0xfrq/studysphere/desktop/screenshots/1-tersembunyi.png

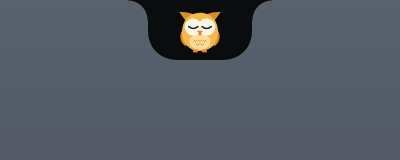
desktop/screenshots/1-tersembunyi.png
