0xfrq/studysphere/desktop/screenshots/3-terbuka.png

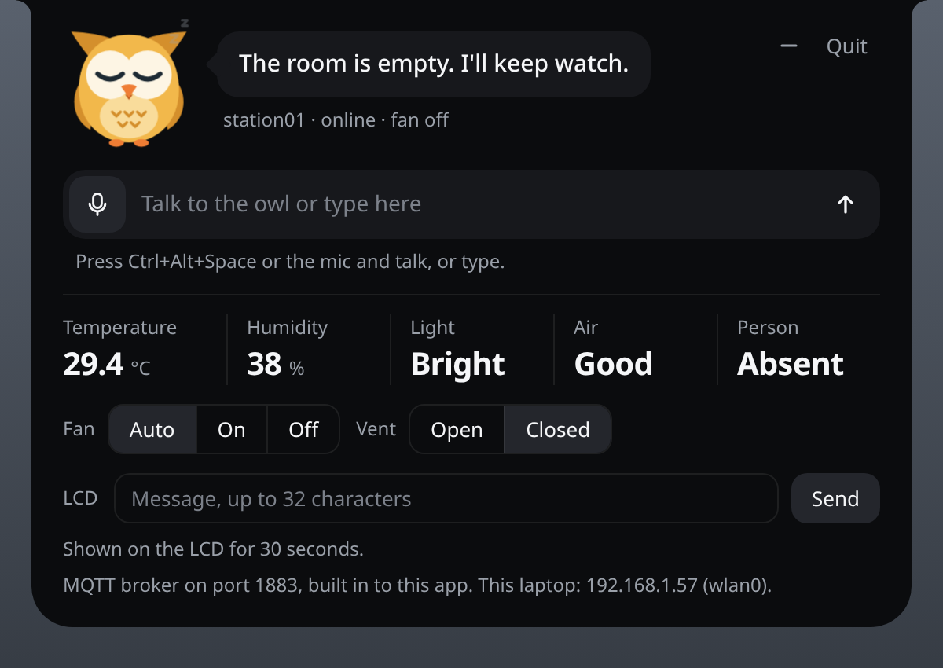
desktop/screenshots/3-terbuka.png
