0xfrq/studysphere/hardware/fab/render-bottom.png

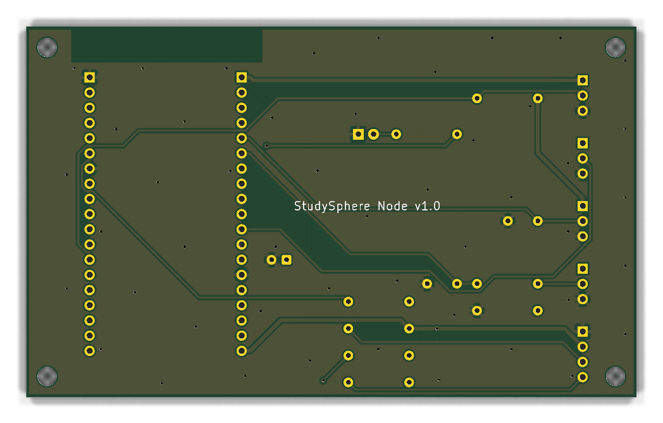
hardware/fab/render-bottom.png
