0xfrq/studysphere/hardware/fab/render-top.png

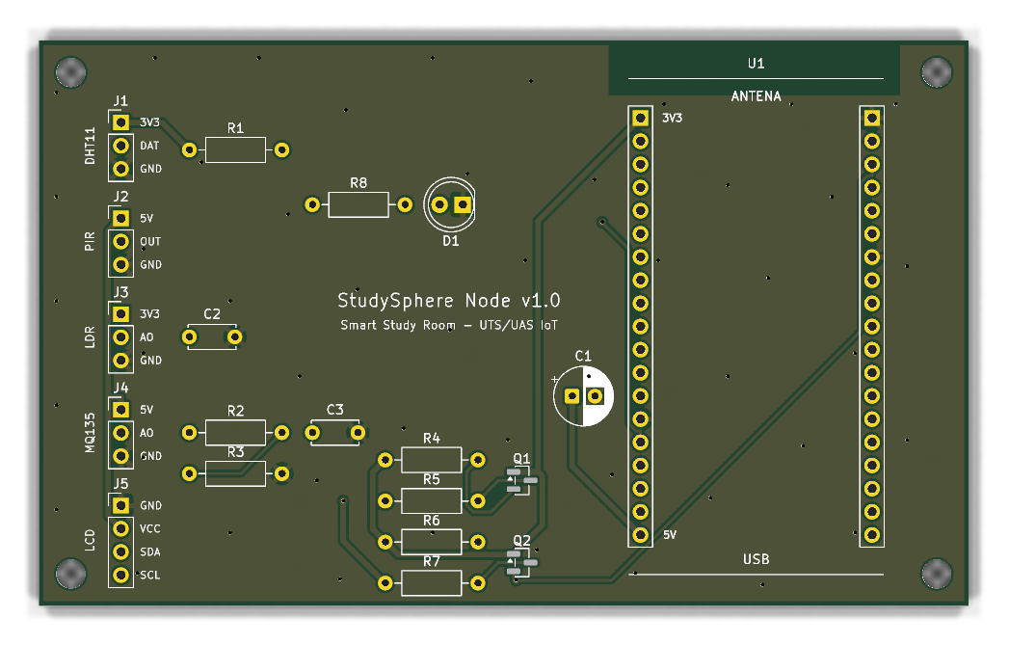
hardware/fab/render-top.png
