0xfrq/studysphere/hardware/fab/bom.csv

Ref | Value | Footprint | Qty
C1 | 100u 16V | Capacitor_THT:CP_Radial_D6.3mm_P2.50mm | 1
C2,C3 | 100n | Capacitor_THT:C_Disc_D5.0mm_W2.5mm_P5.00mm | 2
D1 | LED kuning | LED_THT:LED_D5.0mm | 1
J1 | DHT11 | Connector_PinHeader_2.54mm:PinHeader_1x03_P2.54mm_Vertical | 1
J2 | HC-SR501 | Connector_PinHeader_2.54mm:PinHeader_1x03_P2.54mm_Vertical | 1
J3 | Modul LDR | Connector_PinHeader_2.54mm:PinHeader_1x03_P2.54mm_Vertical | 1
J4 | MQ-135 | Connector_PinHeader_2.54mm:PinHeader_1x03_P2.54mm_Vertical | 1
J5 | LCD 16x2 I2C | Connector_PinHeader_2.54mm:PinHeader_1x04_P2.54mm_Vertical | 1
Q1,Q2 | BSS138 | Package_TO_SOT_SMD:SOT-23 | 2
R1,R2,R4,R5,R6,R7 | 10k | Resistor_THT:R_Axial_DIN0207_L6.3mm_D2.5mm_P10.16mm_Horizontal | 6
R3 | 15k | Resistor_THT:R_Axial_DIN0207_L6.3mm_D2.5mm_P10.16mm_Horizontal | 1
R8 | 220 | Resistor_THT:R_Axial_DIN0207_L6.3mm_D2.5mm_P10.16mm_Horizontal | 1
U1 | ESP32-DevKitC-V4 | studysphere:ESP32-DevKitC-V4_Socket | 1
