0xfrq/studysphere/hardware/fab/skematik.pdf

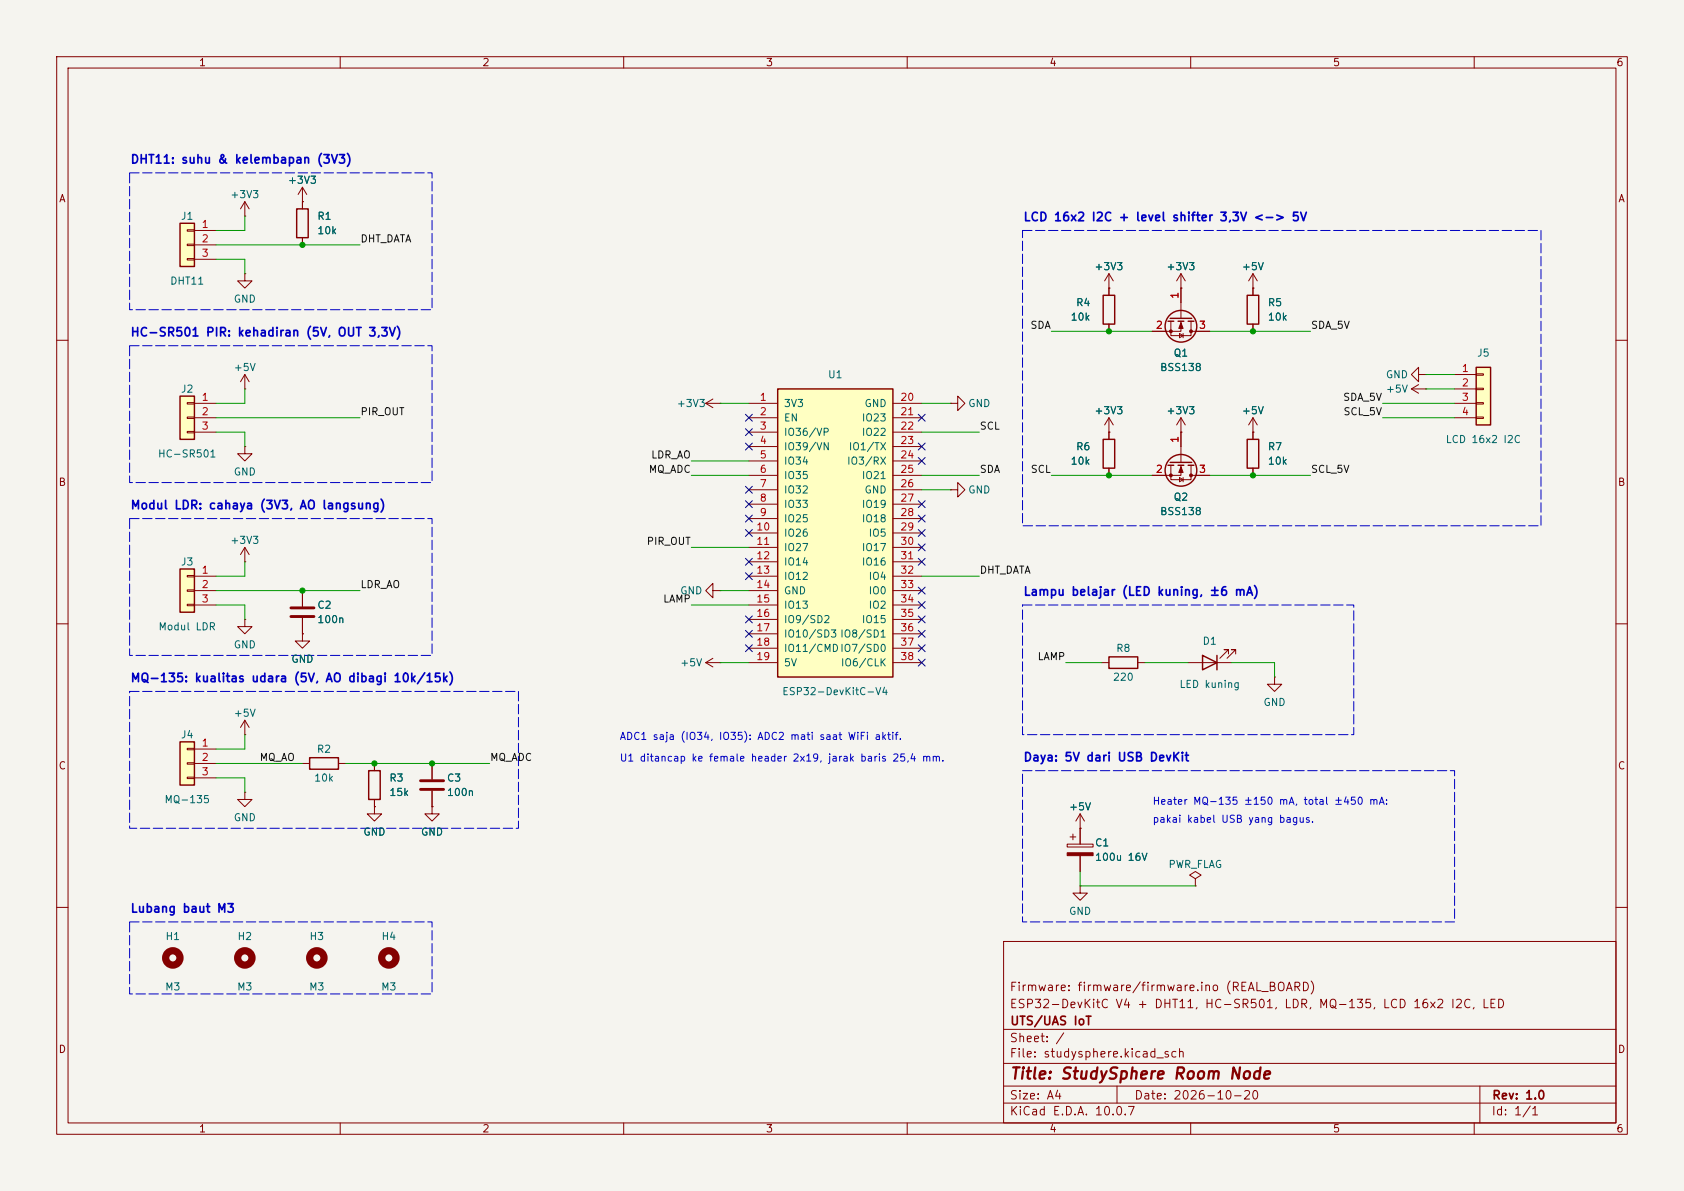
[picture p9: page 1]

SCL DHT_DATA PIR_OUT HC-SR501 PIR: kehadiran (5V, OUT 3,3V)

Modul LDR: cahaya (3V3, AO langsung)

Lampu belajar (LED kuning, ±6 mA)

MQ-135: kualitas udara (5V, AO dibagi 10k/15k)C3

pakai kabel USB yang bagus. Heater MQ-135 ±150 mA, total ±450 mA:

Firmware: firmware/firmware.ino (REAL_BOARD) PWR_FLAG

ESP32-DevKitC V4 + DHT11, HC-SR501, LDR, MQ-135, LCD 16x2 I2C, LED
UTS/UAS IoT
Sheet: /
File: studysphere.kicad_sch
Title: StudySphere Room Node

Size: A4 | Rev: 1.0
KiCad E.D.A. 10.0.7 | Id: 1/1
