0xfrq/studysphere/hardware/fab/pcb-bottom.pdf

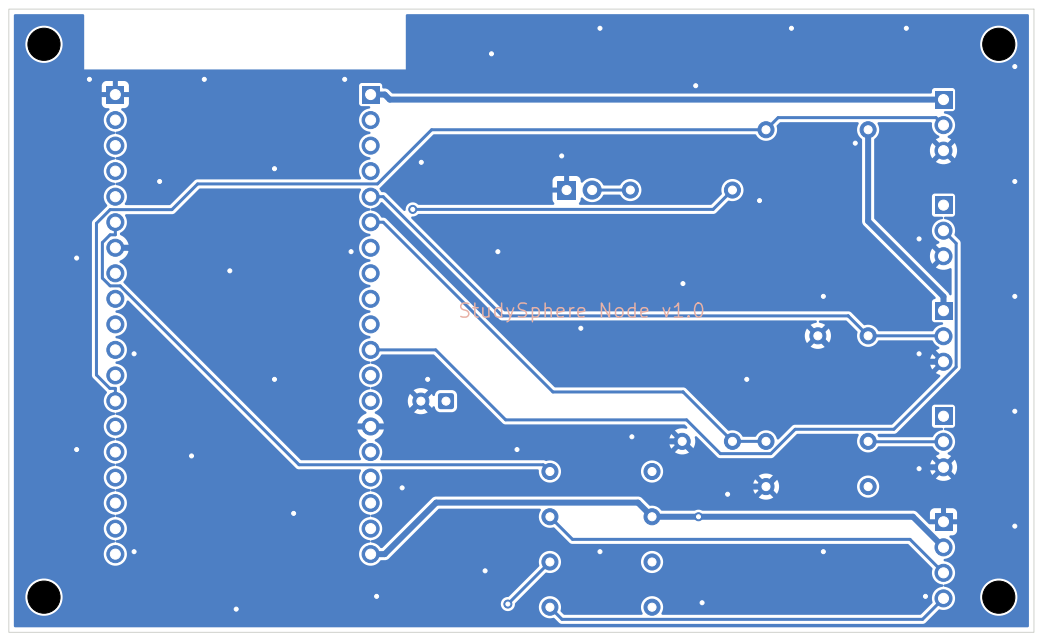
[picture p10: page 1]
