0xfrq/studysphere/hardware/fab/pcb-top.pdf

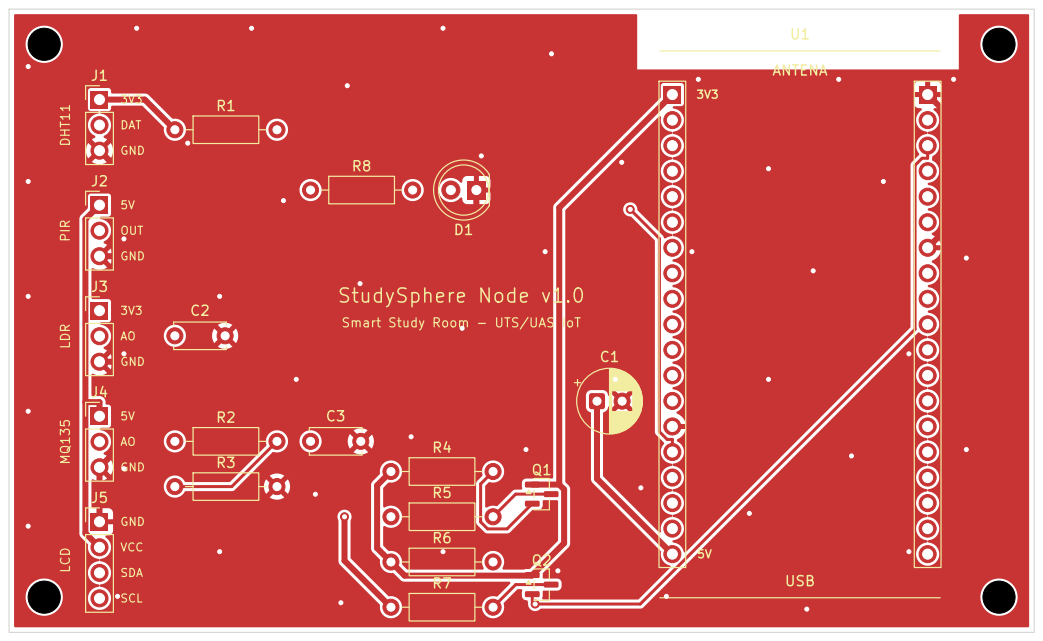
[picture p11: page 1]
