0xfrq/studysphere/hardware/studysphere.kicad_pcb

## KiCad design hardware/studysphere.kicad_pcb (2026-10-21)

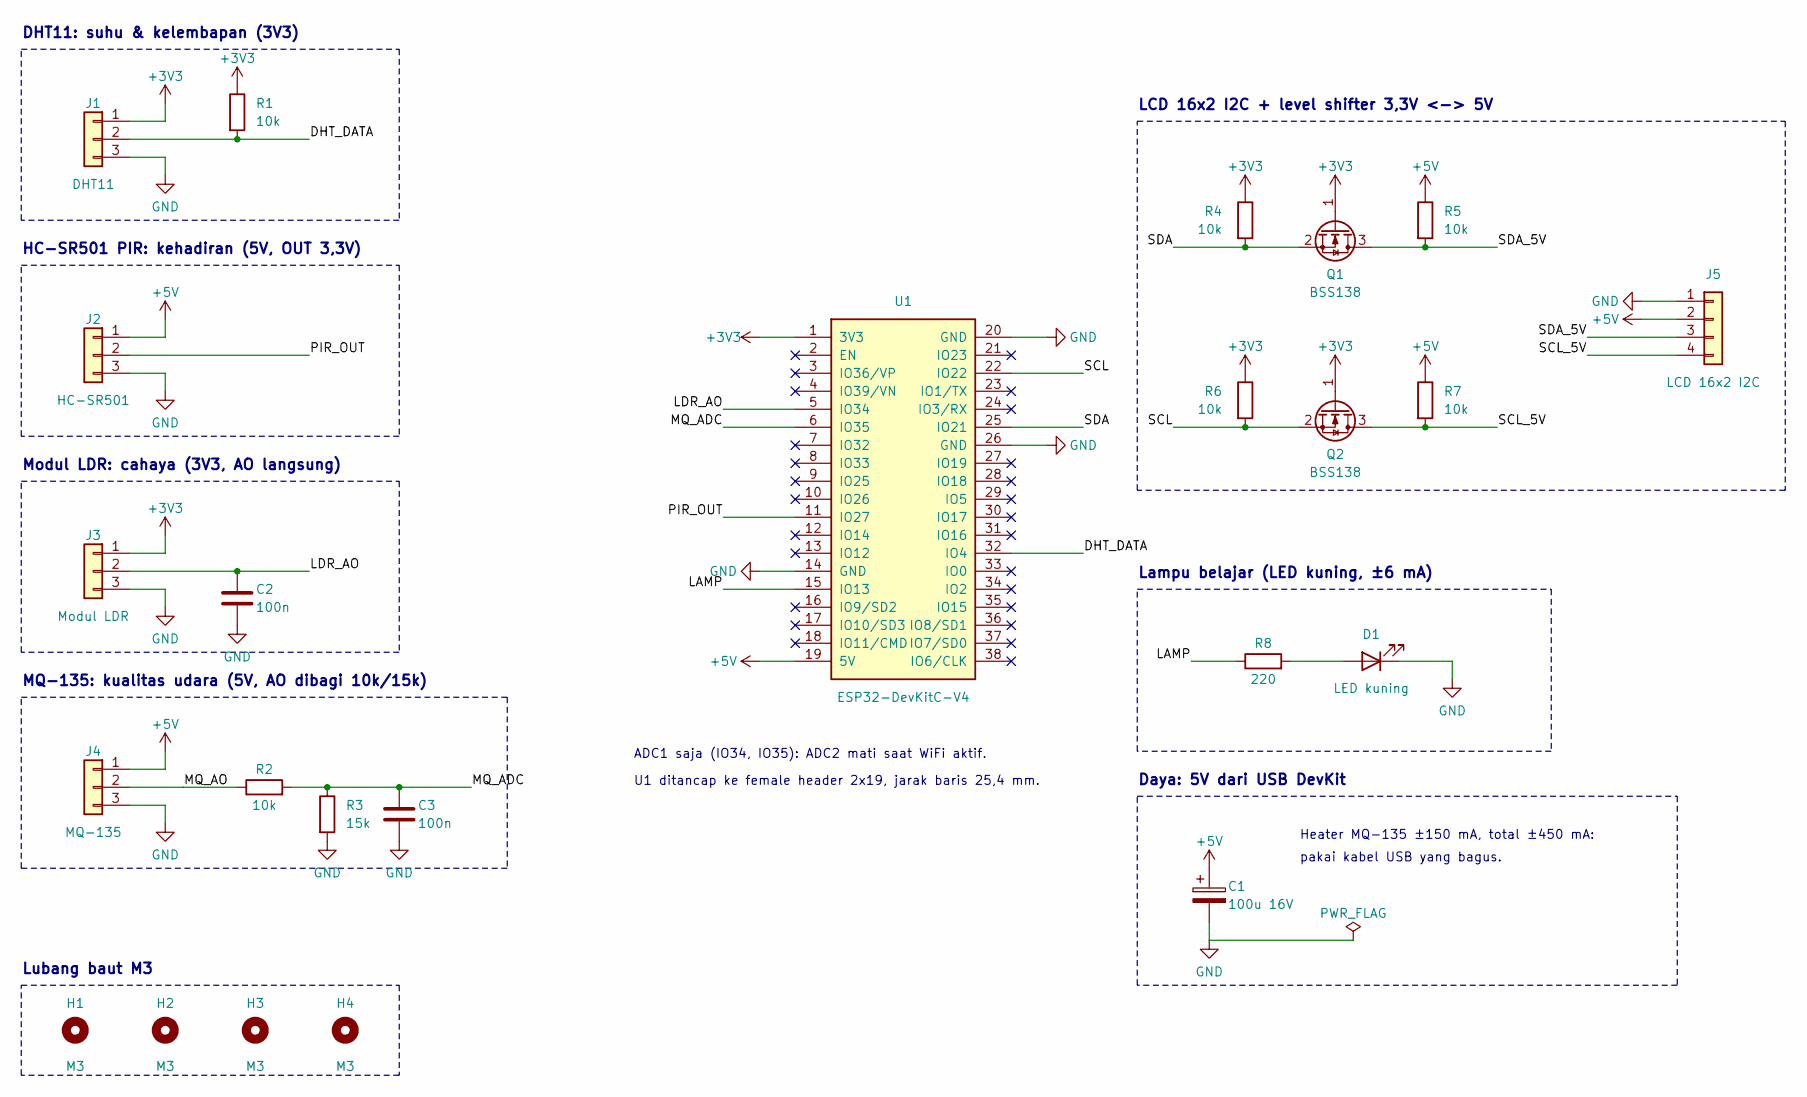
[picture p12: schematic studysphere.kicad_sch, StudySphere Room Node]

Parts:
C1: 100u 16V; CP_Radial_D6.3mm_P2.50mm
C2, C3: 100n; C_Disc_D5.0mm_W2.5mm_P5.00mm
D1: LED kuning; LED_D5.0mm
H1, H2, H3, H4: M3; MountingHole_3.2mm_M3
J1: DHT11; PinHeader_1x03_P2.54mm_Vertical
J2: HC-SR501; PinHeader_1x03_P2.54mm_Vertical
J3: Modul LDR; PinHeader_1x03_P2.54mm_Vertical
J4: MQ-135; PinHeader_1x03_P2.54mm_Vertical
J5: LCD 16x2 I2C; PinHeader_1x04_P2.54mm_Vertical
Q1, Q2: BSS138; SOT-23
R1, R2, R4, R5, R6, R7: 10k; R_Axial_DIN0207_L6.3mm_D2.5mm_P10.16mm_Horizontal
R3: 15k; R_Axial_DIN0207_L6.3mm_D2.5mm_P10.16mm_Horizontal
R8: 220; R_Axial_DIN0207_L6.3mm_D2.5mm_P10.16mm_Horizontal
U1: ESP32-DevKitC-V4; ESP32-DevKitC-V4_Socket

Connections:
+3V3: J1.1, J3.1, Q1.1 (G), Q2.1 (G), R1.1, R4.1, R6.1, U1.1 (3V3)
+5V: C1.1, J2.1, J4.1, J5.2, R5.1, R7.1, U1.19 (5V)
/DHT_DATA: J1.2, R1.2, U1.32 (IO4)
/LAMP: R8.1, U1.15 (IO13)
/LDR_AO: C2.1, J3.2, U1.5 (IO34)
/MQ_ADC: C3.1, R2.2, R3.1, U1.6 (IO35)
/MQ_AO: J4.2, R2.1
/PIR_OUT: J2.2, U1.11 (IO27)
/SCL: Q2.2 (S), R6.2, U1.22 (IO22)
/SCL_5V: J5.4, Q2.3 (D), R7.2
/SDA: Q1.2 (S), R4.2, U1.25 (IO21)
/SDA_5V: J5.3, Q1.3 (D), R5.2
GND: C1.2, C2.2, C3.2, D1.1 (K), J1.3, J2.3, J3.3, J4.3, J5.1, R3.2, U1.14 (GND), U1.20 (GND), U1.26 (GND)
unnamed: D1.2 (A), R8.2

Notes on the sheet:
Heater MQ-135 ±150 mA, total ±450 mA:
HC-SR501 PIR: kehadiran (5V, OUT 3,3V)
Daya: 5V dari USB DevKit
LCD 16x2 I2C + level shifter 3,3V <-> 5V
pakai kabel USB yang bagus.
ADC1 saja (IO34, IO35): ADC2 mati saat WiFi aktif.
MQ-135: kualitas udara (5V, AO dibagi 10k/15k)
Lubang baut M3
Modul LDR: cahaya (3V3, AO langsung)
Lampu belajar (LED kuning, ±6 mA)
U1 ditancap ke female header 2x19, jarak baris 25,4 mm.
DHT11: suhu & kelembapan (3V3)

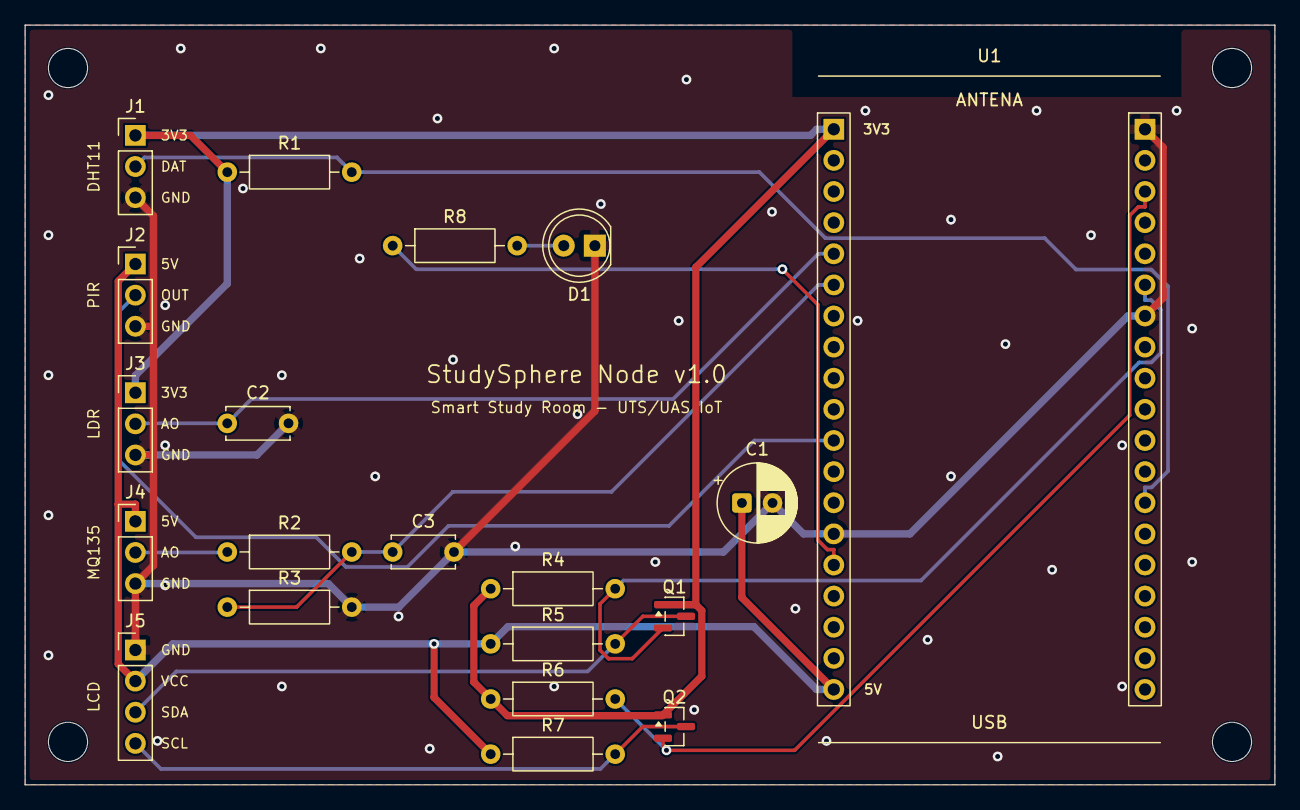
[picture p13: board studysphere.kicad_pcb from above]

Board: 2 copper layers, 102.0 x 62.0 mm, 24 parts (0 on the bottom side), 14 nets.
